lilfolr/ELEC4403_Group111/img/project_img1.jpg

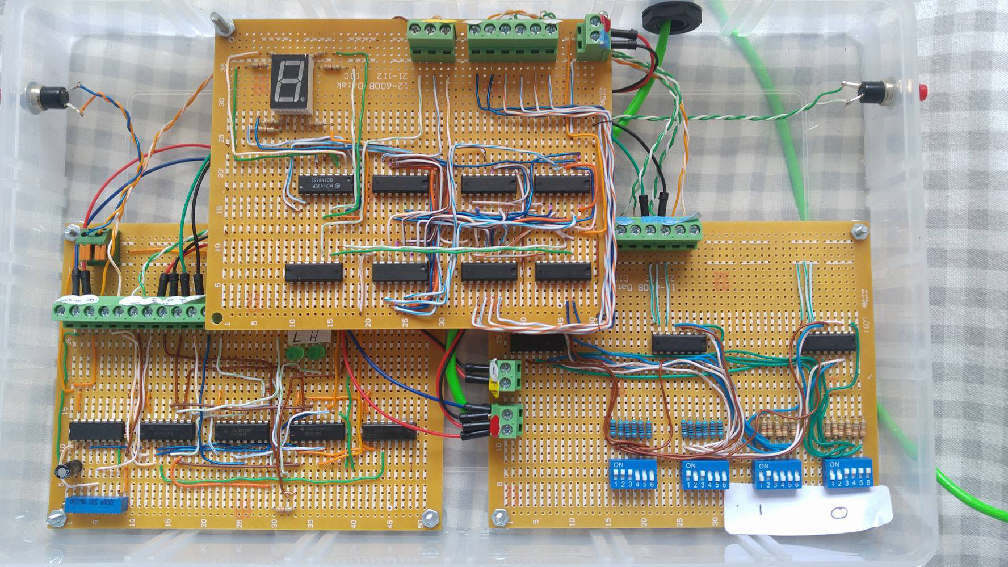
img/project_img1.jpg
