lilfolr/ELEC4403_Group111/resources/project_img1.jpg

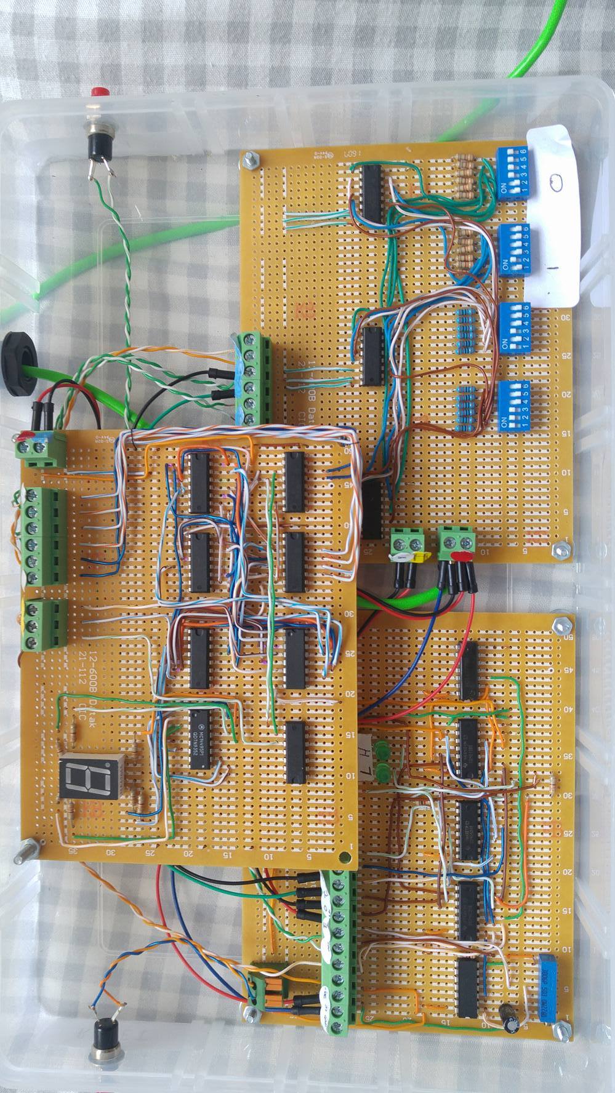
resources/project_img1.jpg
