lilfolr/ELEC4403_Group111/resources/Bill_Of_Material.xlsx

Item | Part number | Part Name and Description | Qty | Price per unit | Price sum | Sources | Operating Voltage (V)
1 | P1308 | 3-6.5mm DIA IP68 Waterproof Cable Glands - Pk.2 | 1 | $4.95 | $4.95 | Jaycar Electronics | N/A
2 | 74LS283 | IC 74LS283 4BITS BINARY Adder | 1 | $3.95 | $3.95 | Jaycar Electronics | 5
3 | CD4052B | 4052 4-Channel Multiplexer/Demultiplexer CMOS IC | 6 | $1.15 | $6.90 | Jaycar Electronics | 5-15
4 | HCF4076BEY | 4076 Quad D Flip Flop CMOS IC | 3 | $1.75 | $5.25 | Jaycar Electronics | 3-18
5 | R7546 | 3R3 0.25W 5% Carbon Film Resistor PK 10 | 4 | $0.50 | $2.00 | Altronics | N/A
6 | R7582 | 10k 0.25W 5% Carbon Film Resistor PK 10 | 3 | $0.50 | $1.50 | Altronics | N/A
7 | MC14495 | Hex to 7 segment latch / decorder LED driver | 1 | $10.90 | $10.90 | Futurlec | 0.5-18
8 | FND507/LTS542R/S50 RWB | FND507/LTS542R/S50 RWB Common Anode 7 Segment Display | 1 | $3.95 | $3.95 | Jaycar Electronics | 5
9 | HCF4077BEY | 4077 Quad 2-input EXOR Gate CMOS IC | 1 | $1.75 | $1.75 | Jaycar Electronics | 3-20
10 | CD4081BCN | 4081 Quad 2-input AND Gate CMOS IC | 1 | $1.25 | $1.25 | Jaycar Electronics | 3-15
11 | SN74HC04 | 74HC04 Hex Inverter IC | 1 | $1.35 | $1.35 | Jaycar Electronics | 2-6
12 | CD4013B | 4013 Dual D Flip Flop CMOS IC | 1 | $1.15 | $1.15 | Jaycar Electronics | 3-15
13 | ZD0150 | Green 5mm LED 12mCd Round Diffused | 2 | $0.00 | $0.00 | Pre-owned | 2.3(Up to 5)
14 | S3055 | 6 Way DIP Switch | 4 | $1.95 | $7.80 | Altronics | 3.5-24
15 | RT4618 | 50Kohm Multiturn Cermet Trimpot | 1 | $1.95 | $1.95 | Jaycar Electronics | N/A
16 | RL6414 | 1uF 50VDC Low Leakage Electrolytic Capacitor | 1 | $0.48 | $0.48 | Jaycar Electronics | N/A
17 | SP0710 | Red Miniature Pushbutton - SPST Momentary Action 125V 1A rating | 2 | $1.65 | $3.30 | Jaycar Electronics | 0-125
18 | MM74C14M | 74C14 Hex Schmitt Trigger CMOS IC | 1 | $1.75 | $1.75 | Jaycar Electronics | 3-15
19 | H0719 | 110 x 140mm DIP Spacing Prototyping PCB | 2 | $5.95 | $11.90 | Altronics | N/A
20 | H0719 | PCB Prototyping board large | 1 | $5.40 | $5.40 | Altronics | N/A
21 | HP0980 | 6mm Nylon PCB Spacers - Pk.5 | 1 | $2.75 | $2.75 | Altronics | N/A
22 | P2040A | Terminal Block PCB 2W 5.08mm | 8 | $1.05 | $8.40 | Altronics | N/A
23 | P2041A | Terminal Block PCB 3W 5.08mm | 6 | $1.40 | $8.40 | Altronics | N/A
24 | W2766 | CAT 6 network cable | 2 | $1.30 | $2.60 | Altronics | N/A
25 | DC power cable | 2m USB cable | 1 | $0.00 | $0.00 | Pre-owned | 0-5
26 | Storage box | 310x200x50mm transparent casing | 1 | $0.00 | $0.00 | Pre-owned | N/A
27 | Mounting accessaries | Bolts, washers, and nuts (mixed) | 1 | $0.00 | $0.00 | Pre-owned | N/A
 |  |  |  | Total cost | $99.63
