lilfolr/ELEC4403_Group111/(list of files, drawings)

Other design files:
resources/HardwareSchematicDesign.fzz
