lilfolr/ELEC4403_Group111/(commit log)

2016-10-25 Fix some links
    [Bill_Of_Material.xlsx, HardwareSchematicDesign.fzz]
2016-10-27 Update attachments
    [Bill_Of_Material.xlsx]
2016-10-30 Update files
    [Bill_Of_Material.xlsx]
